Ardelean-Calin/plantbuddy-hw/3dcase/case.FCStd

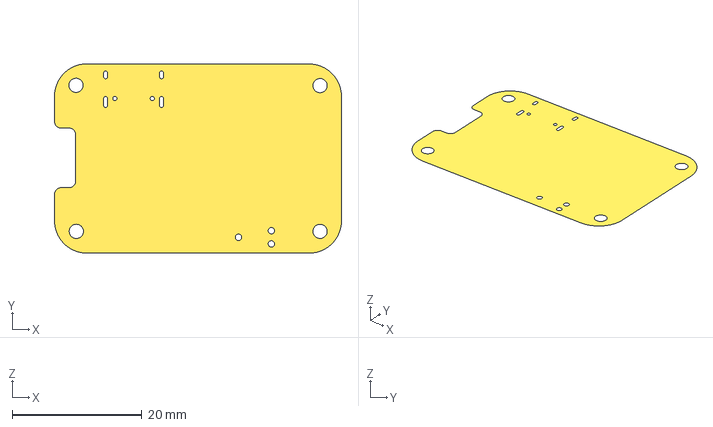
[picture p1: CAD file, 2022-11-03]
3dcase/case.FCStd
44.3 x 29.3 x 0 mm
