Ardelean-Calin/plantbuddy-hw/PlantBuddy.step

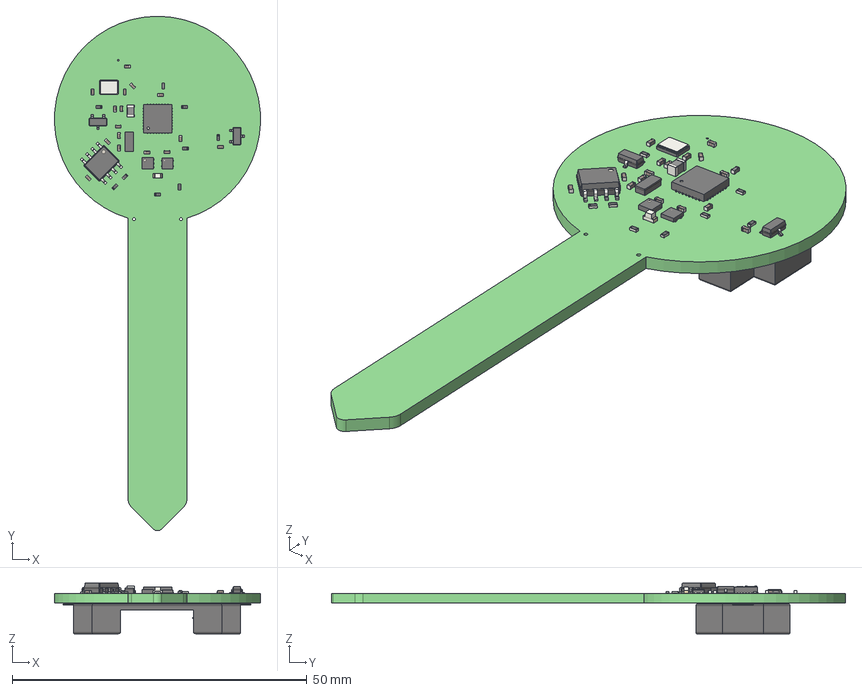
[picture p2: CAD file, 2021-03-22]
PlantBuddy.step
35.0 x 87.3 x 8.63 mm
