Ardelean-Calin/plantbuddy-hw/PlantBuddy.kicad_pcb

## KiCad design PlantBuddy.kicad_pcb (2023-06-27)

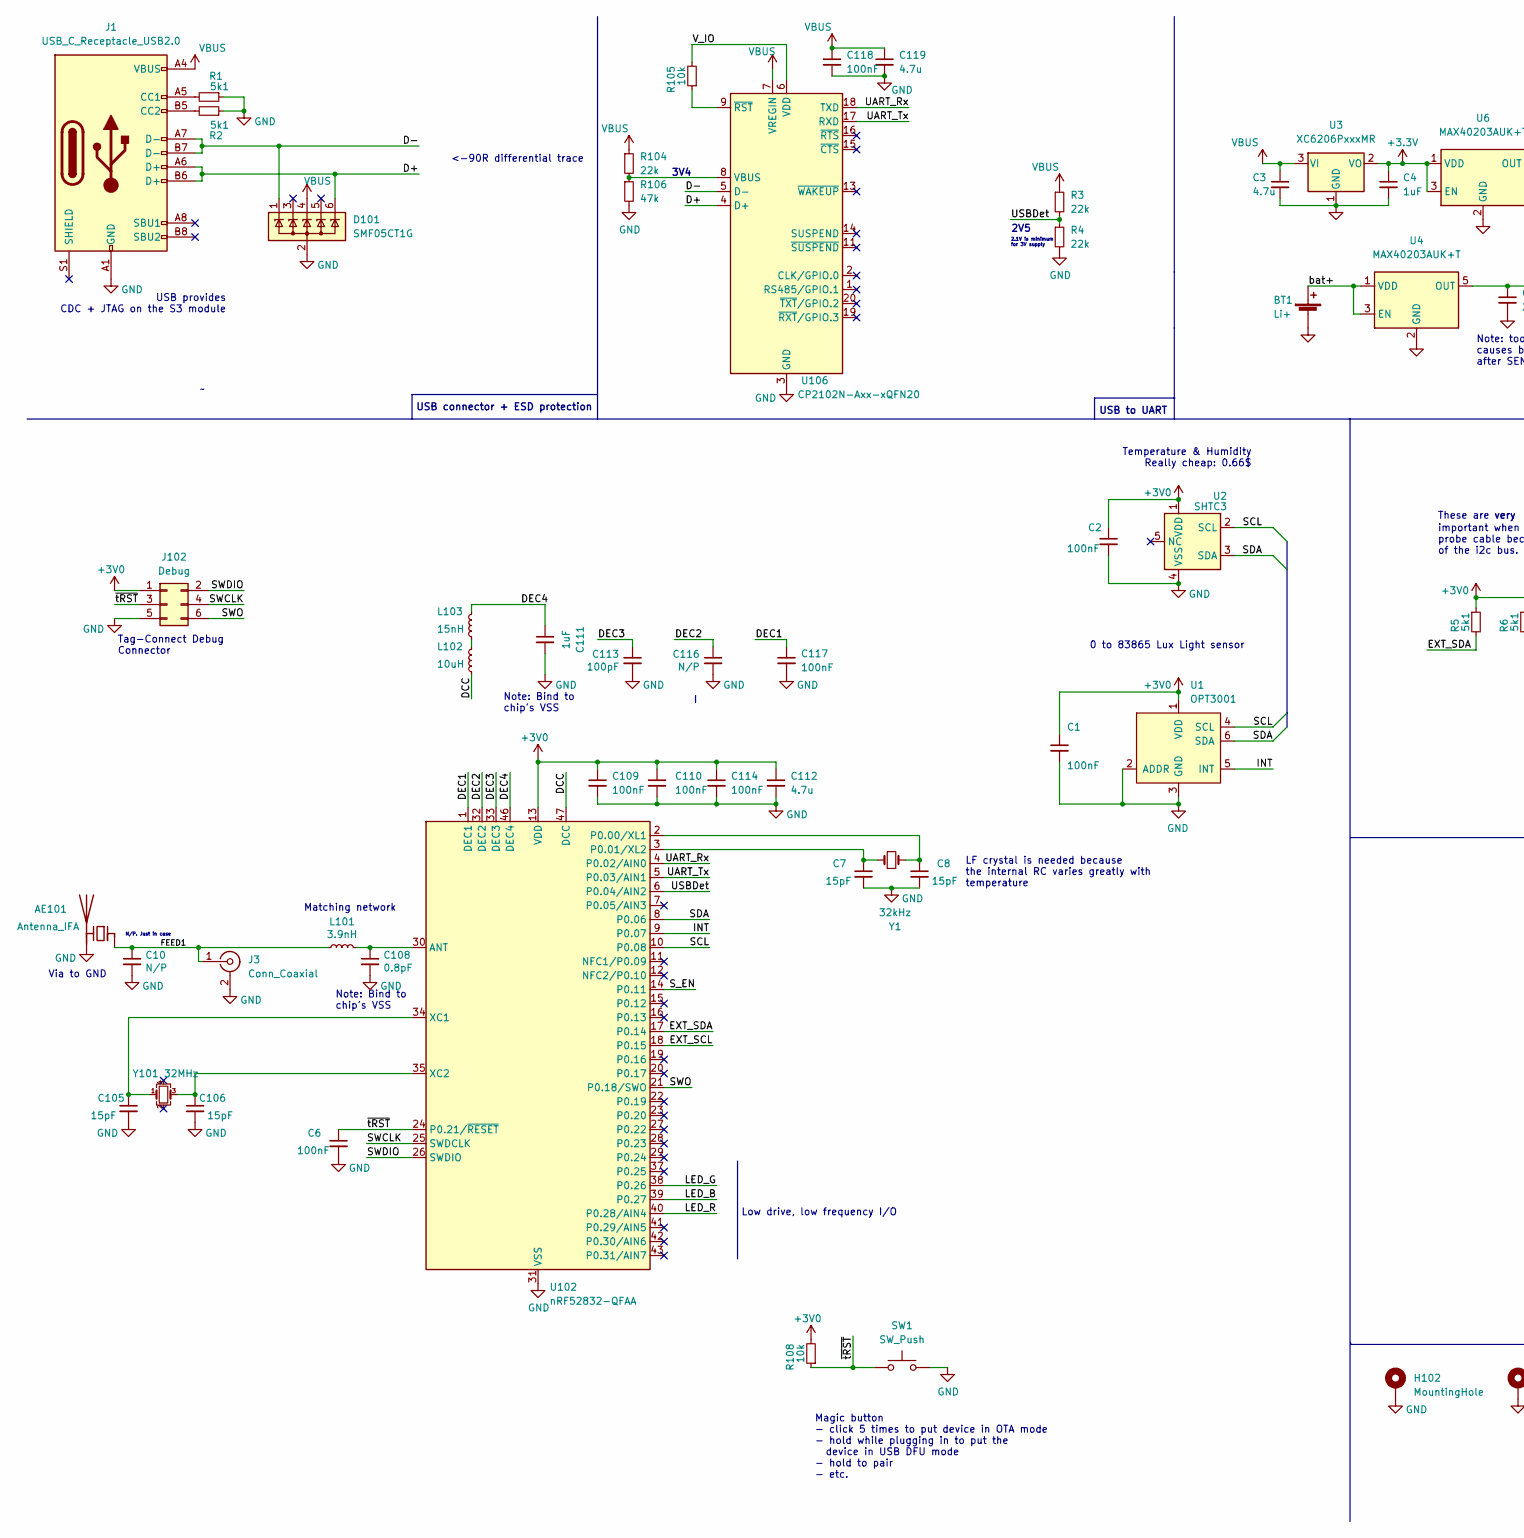
[picture p3: schematic PlantBuddy.kicad_sch, Plant Buddy, part in row 1, column 1]

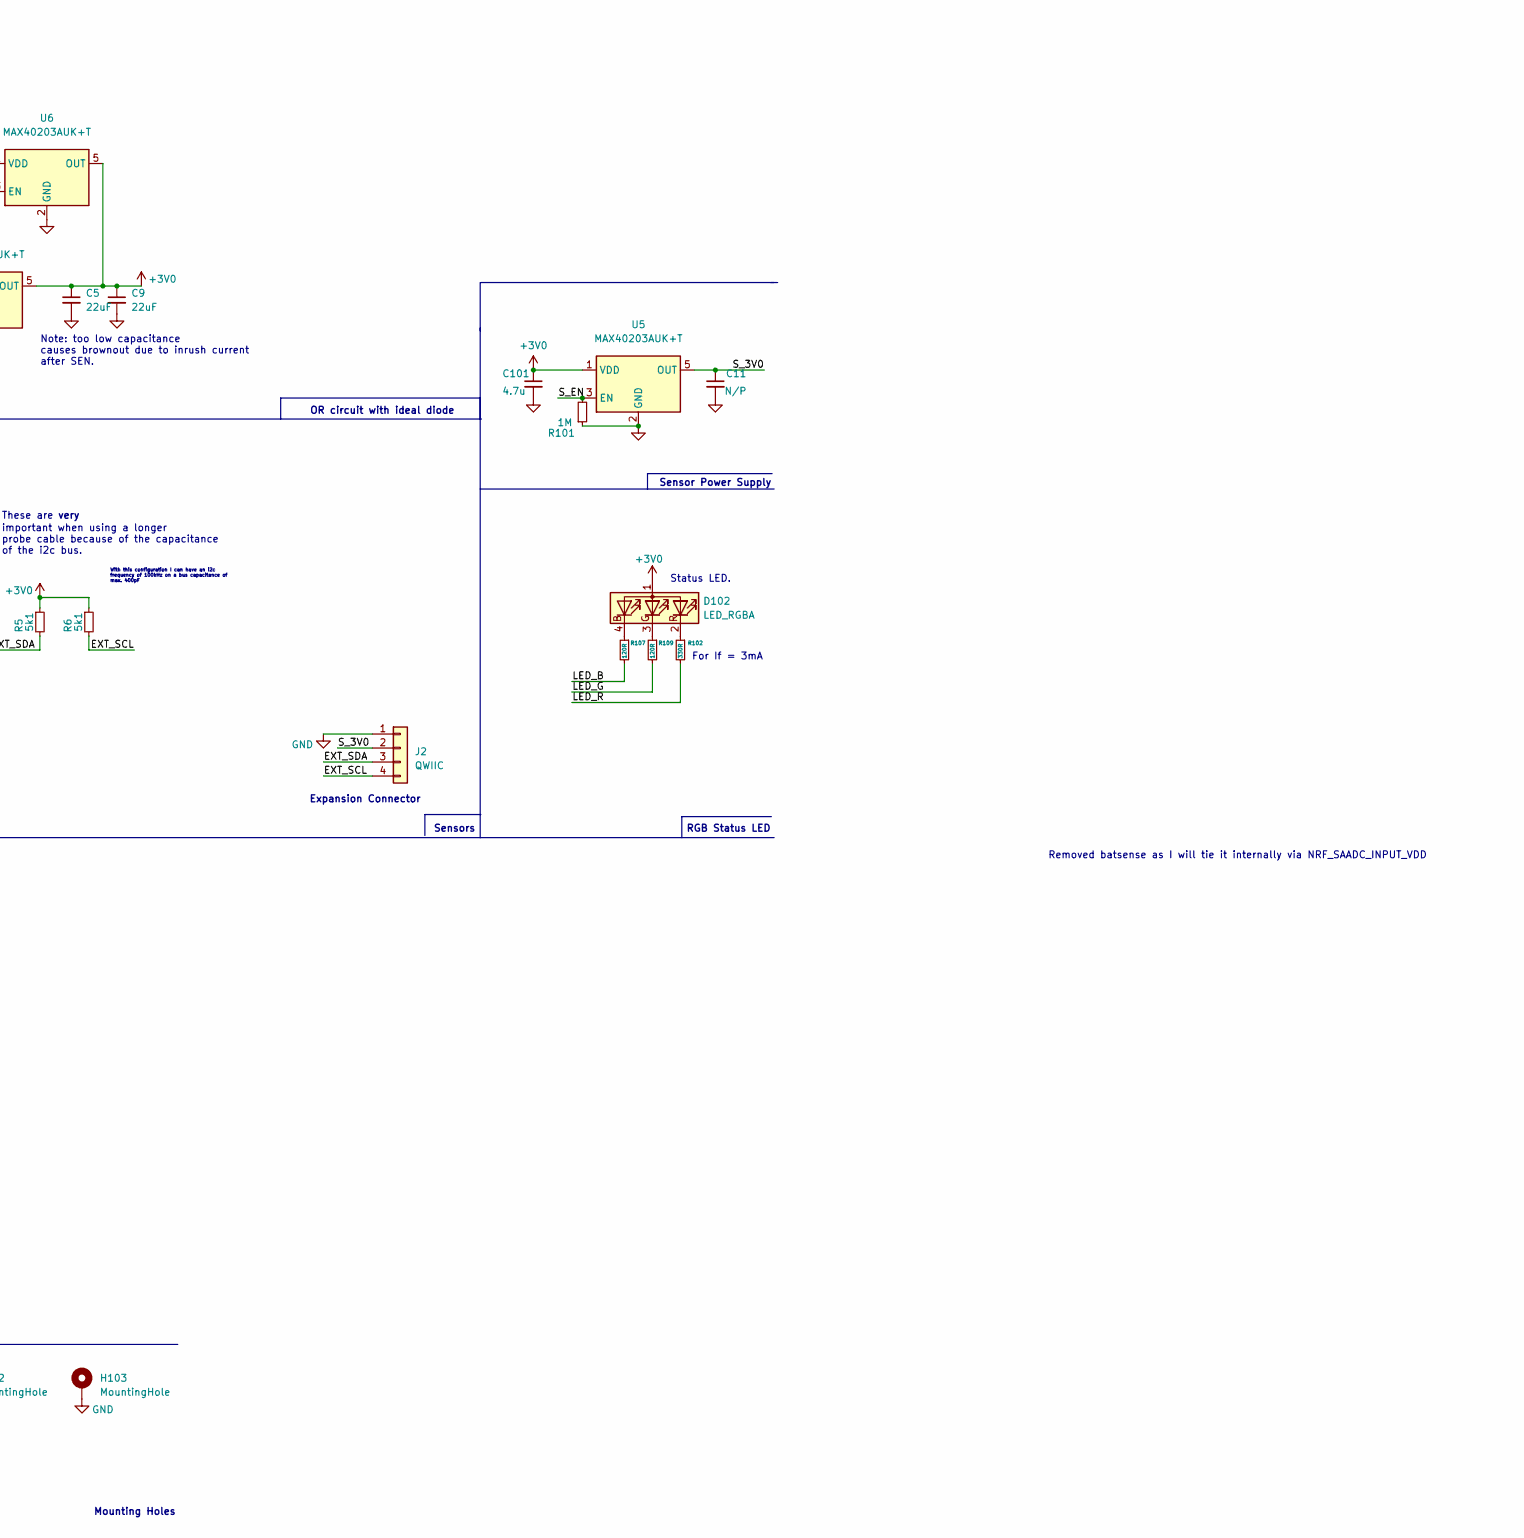
[picture p4: schematic PlantBuddy.kicad_sch, Plant Buddy, part in row 1, column 2]

Parts:
AE101: Antenna_IFA; ANT-F-1-2.4G-1.6MM-FR4-WCH
BT1: Li+; BatteryHolder_LCSC_2032; LCSC C70377
C1, C2, C109, C110, C114, C117, C118: 100nF; C_0402_1005Metric; MPN CC0603KRX7R9BB104; LCSC C307331
C3, C101, C112, C119: 4.7u; C_0402_1005Metric; MPN CL10A475KO8NNNC; LCSC C23733
C4: 1uF; C_0402_1005Metric; MPN CL10A475KO8NNNC; LCSC C52923
C5, C9: 22uF; C_0603_1608Metric; MPN CL10A475KO8NNNC; LCSC C59461
C6: 100nF; C_0402_1005Metric; MPN CL10A475KO8NNNC; LCSC C307331
C7, C8, C105, C106: 15pF; C_0402_1005Metric; LCSC C1548
C10, C116: N/P; C_0402_1005Metric
C11: N/P; C_0402_1005Metric; MPN CL10A475KO8NNNC
C108: 0.8pF; C_0402_1005Metric; LCSC C172820
C111: 1uF; C_0402_1005Metric; MPN CC0603KRX7R9BB104; LCSC C52923
C113: 100pF; C_0402_1005Metric; LCSC C1546
D101: SMF05CT1G; SOT-363_SC-70-6; LCSC C15879
D102: LED_RGBA; LED_Lumex_SML-LX0404SIUPGUSB; LCSC C404280
H102, H103: MountingHole; MountingHole_3.2mm_M3_DIN965_Pad
J1: USB_C_Receptacle_USB2.0; USB_C_Receptacle_HRO_TYPE-C-31-M-12; MPN TYPE-C-31-M-12; LCSC C165948
J2: QWIIC; JST_SH_SM04B-SRSS-TB_1x04-1MP_P1.00mm_Horizontal; LCSC C160404
J3: Conn_Coaxial; U.FL_Hirose_U.FL-R-SMT-1_Vertical; LCSC C88374
J102: Debug; Tag-Connect_TC2030-IDC-NL_2x03_P1.27mm_Vertical
L101: 3.9nH; L_0402_1005Metric; LCSC C76775
L102: 10uH; L_0603_1608Metric; LCSC C223240
L103: 15nH; L_0402_1005Metric; LCSC C27143
R1, R2, R5, R6: 5k1; R_0402_1005Metric; MPN 0603WAF5101T5E; LCSC C25905
R3, R4, R104: 22k; R_0402_1005Metric; LCSC C25768
R101: 1M; R_0402_1005Metric; MPN 0603WAF2004T5E; LCSC C26083
R102: 330R; R_0402_1005Metric; LCSC C25104
R105, R108: 10k; R_0402_1005Metric; MPN 0603WAF5101T5E; LCSC C25744
R106: 47k; R_0402_1005Metric; LCSC C25792
R107, R109: 120R; R_0402_1005Metric; LCSC C25079
SW1: SW_Push; SW_Push_SPST_NO_Alps_SKRK; MPN SKRKAEE020; LCSC C115357
U1: OPT3001; SON65P200X200X65-7N; LCSC C90462
U2: SHTC3; SON100P200X200X80-5N; MPN SHTC3; LCSC C194656
U3: XC6206PxxxMR; SOT-23; LCSC C5446
U4, U5, U6: MAX40203AUK+T; SOT-23-5; LCSC C2653639
U102: nRF52832-QFAA; QFN-48-1EP_6x6mm_P0.4mm_EP4.6x4.6mm; LCSC C77540
U106: CP2102N-Axx-xQFN20; SiliconLabs_QFN-20-1EP_3x3mm_P0.5mm_EP1.8x1.8mm; LCSC C969913
Y1: 32kHz; Crystal_SMD_3215-2Pin_3.2x1.5mm; LCSC C32346
Y101: 32MHz; Crystal_SMD_3225-4Pin_3.2x2.5mm; LCSC C90934

Connections:
+3.3V: C4.1, U3.2 (VO), U6.1 (VDD), U6.3 (EN)
+3V0: C1.1, C2.1, C5.1, C9.1, C101.1, C109.1, C110.1, C112.1, C114.1, D102.1 (A), J102.1, R5.1, R6.1, R108.2, U1.1 (VDD), U2.1 (VDD), U4.5 (OUT), U5.1 (VDD), U6.5 (OUT), U102.13 (VDD), U102.36 (VDD), U102.48 (VDD)
/D+: D101.6 (K), J1.A6 (D+), J1.B6 (D+), U106.4 (D+)
/D-: D101.1 (K), J1.A7 (D-), J1.B7 (D-), U106.5 (D-)
/DCC: L102.2, U102.47 (DCC)
/DEC1: C117.1, U102.1 (DEC1)
/DEC2: C116.1, U102.32 (DEC2)
/DEC3: C113.1, U102.33 (DEC3)
/DEC4: C111.1, L103.1, U102.46 (DEC4)
/EXT_SCL: J2.4, R6.2, U102.18 (P0.15)
/EXT_SDA: J2.3, R5.2, U102.17 (P0.14)
/FEED1: AE101.1 (FEED), C10.1, J3.1 (In), L101.1
/INT: U1.5 (INT), U102.9 (P0.07)
/LED_B: R107.2, U102.39 (P0.27)
/LED_G: R109.2, U102.38 (P0.26)
/LED_R: R102.2, U102.40 (P0.28/AIN4)
/SCL: U1.4 (SCL), U2.2 (SCL), U102.10 (P0.08)
/SDA: U1.6 (SDA), U2.3 (SDA), U102.8 (P0.06)
/SWCLK: J102.4, U102.25 (SWDCLK)
/SWDIO: J102.2, U102.26 (SWDIO)
/SWO: J102.6, U102.21 (P0.18/SWO)
/S_3V0: C11.1, J2.2, U5.5 (OUT)
/S_EN: R101.2, U5.3 (EN), U102.14 (P0.11)
/UART_Rx: U102.4 (P0.02/AIN0), U106.18 (TXD)
/UART_Tx: U102.5 (P0.03/AIN1), U106.17 (RXD)
/USBDet: R3.2, R4.1, U102.6 (P0.04/AIN2)
/V_IO: R105.2, U106.6 (VDD)
/bat+: BT1.1 (+), U4.1 (VDD), U4.3 (EN)
/~tRST: C6.1, J102.3, R108.1, SW1.1, U102.24 (P0.21/~RESET)
GND: AE101.2 (PCB_Trace), BT1.2 (-), C1.2, C2.2, C3.2, C4.2, C5.2, C6.2, C7.2, C8.2, C9.2, C10.2, C11.2, C101.2, C105.2, C106.2, C108.2, C109.2, C110.2, C111.2, C112.2, C113.2, C114.2, C116.2, C117.2, C118.2, C119.2, D101.2 (A), H102.1, H103.1, J1.A1 (GND), J1.A12 (GND), J1.B1 (GND), J1.B12 (GND), J2.1, J3.2 (Ext), J102.5, R1.1, R2.1, R4.2, R101.1, R106.2, SW1.2, U1.2 (ADDR), U1.3 (GND), U1.7 (PAD), U2.4 (VSS), U3.1 (GND), U4.2 (GND), U5.2 (GND), U6.2 (GND), U102.31 (VSS), U102.45 (VSS), U102.49 (VSS), U106.3 (GND), U106.12 (GND), U106.21 (GND)
unnamed: D102.4 (BK), R107.1
unnamed: D102.3 (GK), R109.1
unnamed: D102.2 (RK), R102.1
unnamed: J1.A5 (CC1), R1.2
unnamed: J1.B5 (CC2), R2.2
unnamed: L102.1, L103.2
unnamed: C108.1, L101.2, U102.30 (ANT)
unnamed: C8.1, U102.2 (P0.00/XL1), Y1.2
unnamed: C7.1, U102.3 (P0.01/XL2), Y1.1
unnamed: C105.1, U102.34 (XC1), Y101.1
unnamed: C106.1, U102.35 (XC2), Y101.3
unnamed: R104.2, R106.1, U106.8 (VBUS)
unnamed: R105.1, U106.9 (~RST)
VBUS: C3.1, C118.1, C119.1, D101.4 (K), J1.A4 (VBUS), J1.A9 (VBUS), J1.B4 (VBUS), J1.B9 (VBUS), R3.1, R104.1, U3.3 (VI), U106.7 (VREGIN)

Notes on the sheet:
very
Sensors
Note: too low capacitance causes brownout due to inrush current after SEN.
These are
USB provides CDC + JTAG on the S3 module
Magic button - click 5 times to put device in OTA mode - hold while plugging in to put the device in USB DFU mode - hold to pair - etc.
Via to GND
RGB Status LED
Tag-Connect Debug Connector
Expansion Connector
Removed batsense as I will tie it internally via NRF_SAADC_INPUT_VDD
Sensor Power Supply
2.1V is minimum for 3V supply
important when using a longer probe cable because of the capacitance of the i2c bus.
Low drive, low frequency I/O
Note: Bind to chip's VSS
3V4
<-90R differential trace
0 to 83865 Lux Light sensor
Temperature & Humidity Really cheap: 0.66$
With this configuration I can have an i2c frequency of 100kHz on a bus capacitance of max. 400pF
Matching network
Mounting Holes
For If = 3mA
LF crystal is needed because the internal RC varies greatly with temperature
2V5
OR circuit with ideal diode
Status LED.
N/P. Just in case
USB connector + ESD protection
USB to UART

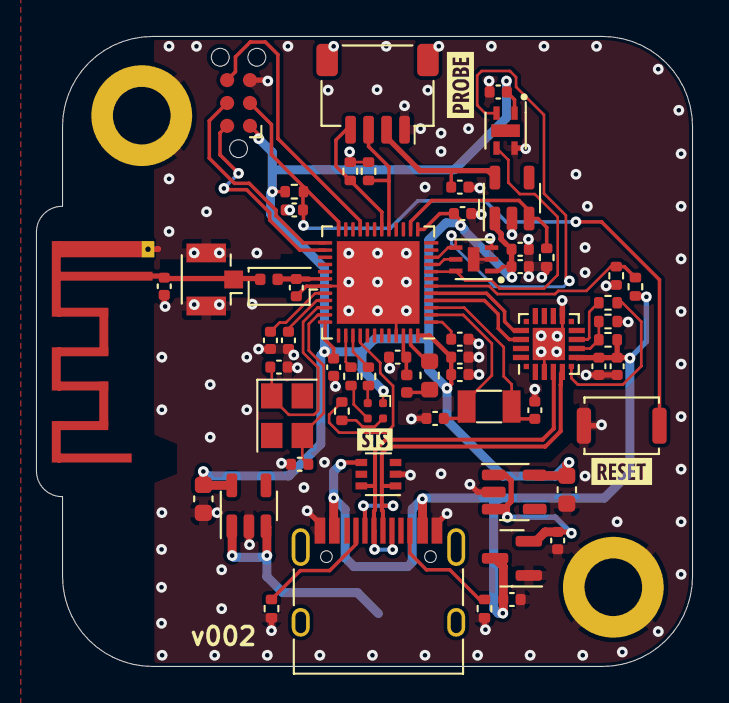
[picture p5: board PlantBuddy.kicad_pcb from above]

Board: 4 copper layers, 36.4 x 35.0 mm, 63 parts (1 on the bottom side), 44 nets.
