Ardelean-Calin/plantbuddy-hw/(commit log)

2020-10-13 Backup. Schematic done, I think
    [BoardOutline.dxf, PlantBuddy.kicad_pcb, PlantBuddy.sch]
2020-10-13 PCB almost done
    [PlantBuddy.kicad_pcb, PlantBuddy.sch]
2020-10-14 Initial Layout done
    [BoardOutline.dxf, PlantBuddy.kicad_pcb, PlantBuddy.sch]
2020-10-15 Ordered PCB
    [PlantBuddy-B_Cu.gbr, PlantBuddy-B_Mask.gbr, PlantBuddy-B_SilkS.gbr, PlantBuddy-Edge_Cuts.gbr, PlantBuddy-F_Cu.gbr, PlantBuddy-F_Mask.gbr, PlantBuddy-F_SilkS.gbr, PlantBuddy-In1_Cu.gbr]
2020-11-04 Evrika! We have an LED blinking! 🔥🎉💯
    [PlantBuddy.kicad_pcb, PlantBuddy.sch]
2020-11-05 Changed LED frequenct
2020-11-10 Removed STM32CubeMx file
2020-11-11 Basic SHT2X temperature logging
2020-11-12 Air Temperature and Humidity now working! 🌡🌧
2020-11-17 Configured timer for soil humidity measurement.
2020-11-17 Just some small typo fix.
    [PlantBuddy.sch]
2020-11-22 Modified I2C read/write operations to be more readable
2020-11-23 Slight refactoring of SHT2X module. Still can't go low-power
2020-11-23 Reduced tick frequency in preparation for low-power
2020-11-26 Added low-power configuration for SHT2X
2020-11-26 Started schematic revision
    [PlantBuddy.sch]
2020-11-28 Revised schematic
    [PlantBuddy.sch]
2020-11-28 Revised PCB
    [PlantBuddy.kicad_pcb]
2020-11-28 Ordered PCB version 2
    [PlantBuddy-B_Cu.gbr, PlantBuddy-B_Mask.gbr, PlantBuddy-B_SilkS.gbr, PlantBuddy-Edge_Cuts.gbr, PlantBuddy-F_Cu.gbr, PlantBuddy-F_Mask.gbr, PlantBuddy-F_SilkS.gbr, PlantBuddy-In1_Cu.gbr]
2020-12-05 Added documentation for the last humidity sensor
2020-12-05 Changed tick frequency to 100Hz
2020-12-24 Added datasheet for lux sensor
2020-12-24 Now reading RH and T with new sensor
2020-12-31 Refactored i2c module & SHT2C driver
2021-01-01 Started communicating with lux sensor
2021-01-02 Lux sensor implementation ready.
2021-01-06 Switched to CMAKE
2021-01-15 Moved to Linux
    [BoardOutline.dxf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]
2021-01-29 Switched to nRF52810.
    [PlantBuddy-B_Cu.gbr, PlantBuddy-B_Mask.gbr, PlantBuddy-B_SilkS.gbr, PlantBuddy-Edge_Cuts.gbr, PlantBuddy-F_Cu.gbr, PlantBuddy-F_Mask.gbr, PlantBuddy-F_SilkS.gbr, PlantBuddy-In1_Cu.gbr]
2021-02-05 Switched to nRF52810
2021-02-05 Disabled LED Button service!
2021-02-15 SHTC3 temperature and humidity now working!
2021-02-15 Added documentation to SHTC3 driver.
2021-02-16 OPT3001 driver done.
2021-02-16 Added battery sensor module.
2021-02-18 LEDs now not blinkin!
2021-02-18 Added buttonless DFU functionality!
2021-02-18 Changed frequency of status LED blinking
2021-02-25 Slight hardware changes.
    [PlantBuddy.sch]
2021-02-25 Added air temperature and humidity characteristics
2021-03-05 Revised 3d models a bit
    [PlantBuddy.kicad_pcb, PlantBuddy.sch, PlantBuddy.step]
2021-03-05 Added 3d model for the case
    [Prototype v29.f3z]
2021-03-09 Slight PCB modifications
    [FlivzNexxy-B_Cu.gbr, FlivzNexxy-B_Mask.gbr, FlivzNexxy-B_SilkS.gbr, FlivzNexxy-Edge_Cuts.gbr, FlivzNexxy-F_Cu.gbr, FlivzNexxy-F_Mask.gbr, FlivzNexxy-F_SilkS.gbr, FlivzNexxy-In1_Cu.gbr]
2021-03-10 Changed to two-layer PCB
    [FlivzNexxy-B_Cu.gbr, FlivzNexxy-B_Mask.gbr, FlivzNexxy-B_SilkS.gbr, FlivzNexxy-Edge_Cuts.gbr, FlivzNexxy-F_Cu.gbr, FlivzNexxy-F_Mask.gbr, FlivzNexxy-F_SilkS.gbr, FlivzNexxy-In1_Cu.gbr]
2021-03-10 Slight modifications to two-layer version
    [FlivzNexxy_BOM.xlsx, PlantBuddy.sch]
2021-03-11 Ordered 2-layer PCB from PCBway
    [FlivzNexxy_BOM.xlsx, PlantBuddy.kicad_pcb]
2021-03-22 Lowered sensor data aquisition time to reduce power.
2021-03-22 Updated 3D model
    [PlantBuddy.step]
2021-04-09 Switched to nRF52811.
2021-04-13 Enabled PIN-based pairing.
2021-04-26 Added timestamp to BLE characteristic. Switched to human-readable representation of humidity and temperature in data packet. Added jupyter notebook that extracts all sensor data.
2021-04-27 Added battery voltage to sensor package (temporary)
2021-04-28 Removed static PIN and made slight adaptations to RELEASE
2021-04-28 Switched to pipenv for python code.
2021-05-09 Switched to Linux... again.
2021-08-06 Just some small UPPER-CASE correction
2021-08-06 Added logging via UART.
2021-08-11 Added devcontainer using docker! 🎉🐋
2021-08-11 Re-added phone app now with docker! 🐋
2021-08-14 PlantBuddy Revision 3. Switched to nRF52832
    [FlivzNexxy-B_Cu.gbr, FlivzNexxy-B_Mask.gbr, FlivzNexxy-B_SilkS.gbr, FlivzNexxy-Edge_Cuts.gbr, FlivzNexxy-F_Cu.gbr, FlivzNexxy-F_Mask.gbr, FlivzNexxy-F_SilkS.gbr, FlivzNexxy-NPTH.drl]
2021-08-15 Fixed revision number.
    [PlantBuddy.sch]
2021-08-16 HW: Rev 4.1 => Changed ALS from OPT3001 to LTR-303
    [PlantBuddy.kicad_pcb, PlantBuddy.sch]
2021-09-04 Started PCB improvements & added SVGs and interactive BOM.
    [PlantBuddy.kicad_pcb, PlantBuddy.sch, PlantBuddy_bom.csv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]
2021-09-05 Added new debug connector for J-Link.
    [PlantBuddy.kicad_pcb, PlantBuddy.sch]
2021-09-06 Embedded: Updated capacitive sensing mechanism.
2021-09-06 PCB: Changed name of net.
    [PlantBuddy.sch]
2021-09-07 Removed unneeded high-level CSENSE driver.
2021-09-09 Corrected device identifier.
2021-09-09 Disabled soilhumidity driver because it didn't work.
2021-09-10 Changed antenna design to monopole
    [PlantBuddy.kicad_pcb, PlantBuddy.sch]
2021-09-10 Switched to 0603 and re-did layout.
    [PlantBuddy.kicad_pcb, PlantBuddy.sch]
2021-09-10 Done with latest HW revision. To be ordered with Aisler.
    [PlantBuddy.kicad_pcb, PlantBuddy.sch]
2021-09-10 Slight adjustments to Antenna ground plane & length.
    [PlantBuddy.kicad_pcb]
2021-09-10 Slight changes to RF trace width.
    [PlantBuddy.kicad_pcb]
2021-09-28 Updated interactive BOM
2021-09-28 Adapted firmware to run on latest development board from AISLER.
2021-09-28 Incipient LTR303 driver.
2021-09-29 SHTC3 driver now works!
2021-10-01 All sensors now working!
2021-10-15 Slight schematic TODO added
    [PlantBuddy.sch]
2021-10-19 Switched to podman.
2021-11-09 Added current sense resistor & COMP resistor.
    [FlivzNexxy-B_Cu.gbl, FlivzNexxy-B_Cu.gbr, FlivzNexxy-B_Mask.gbr, FlivzNexxy-B_Mask.gbs, FlivzNexxy-B_Paste.gbp, FlivzNexxy-B_SilkS.gbo, FlivzNexxy-B_SilkS.gbr, FlivzNexxy-Edge_Cuts.gm1]
2021-11-10 Corrected PCB BOM.
    [BOM_manual_edit.csv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]
2022-04-21 Switched to ESP32
    [PlantBuddy.kicad_pcb, PlantBuddy.kicad_sch]
2022-04-29 Had to change the way we do capacitive soil humidity.
    [FlivzNexxy-B_Cu.gbl, FlivzNexxy-B_Mask.gbs, FlivzNexxy-B_Paste.gbp, FlivzNexxy-B_SilkS.gbo, FlivzNexxy-Edge_Cuts.gm1, FlivzNexxy-F_Cu.gtl, FlivzNexxy-F_Mask.gts, FlivzNexxy-F_Paste.gtp]
2022-05-05 Added tooling holes.
    [PlantBuddy.kicad_pcb, PlantBuddy.kicad_sch]
2022-05-06 Added reverse voltage protection; status LED; changed resistance of green LED; changed piezo footprint
    [PlantBuddy-CmtUser.gbr, PlantBuddy-CuBottom.gbl, PlantBuddy-CuTop.gtl, PlantBuddy-EdgeCuts.gm1, PlantBuddy-MaskBottom.gbs, PlantBuddy-MaskTop.gts, PlantBuddy-PasteBottom.gbp, PlantBuddy-PasteTop.gtp]
2022-05-24 Moved temperature sensor to the edge of the board.
    [PlantBuddy.kicad_pcb, PlantBuddy.kicad_sch]
2022-05-27 Simplified capacitance measurement
    [PlantBuddy.kicad_pcb, PlantBuddy.kicad_sch]
2022-06-15 Temperature calibrated capacitive sensing & ordered from JLCPCB
    [PlantBuddy-CmtUser.gbr, PlantBuddy-CuBottom.gbl, PlantBuddy-CuTop.gtl, PlantBuddy-EdgeCuts.gm1, PlantBuddy-MaskBottom.gbs, PlantBuddy-MaskTop.gts, PlantBuddy-PasteBottom.gbp, PlantBuddy-PasteTop.gtp]
2022-06-19 Removed previous CPL file
    [FlivzNexxy_cpl_top.csv]
2022-06-27 New board based on ESP32-S3 mostly done. Waiting for part availability...
    [PlantBuddy.kicad_pcb, PlantBuddy.kicad_sch]
2022-06-28 Removed reverse protection circuit as it did nothing to protect the battery charger from reverse voltage.
    [PlantBuddy.kicad_pcb, PlantBuddy.kicad_sch]
2022-06-28 Silkscreen & testpoints
    [PlantBuddy-CmtUser.gbr, PlantBuddy-CuBottom.gbl, PlantBuddy-CuTop.gtl, PlantBuddy-EdgeCuts.gm1, PlantBuddy-MaskBottom.gbs, PlantBuddy-MaskTop.gts, PlantBuddy-PasteBottom.gbp, PlantBuddy-PasteTop.gtp]
2022-06-28 Changed pin layout to have more EXT pins
    [PlantBuddy.kicad_pcb, PlantBuddy.kicad_sch]
2022-06-30 Added different mezzannine connector
    [PlantBuddy.kicad_pcb, PlantBuddy.kicad_sch]
2022-07-01 Changed connector to a more solid one.
    [PlantBuddy-CmtUser.gbr, PlantBuddy-CuBottom.gbl, PlantBuddy-CuTop.gtl, PlantBuddy-EdgeCuts.gm1, PlantBuddy-MaskBottom.gbs, PlantBuddy-MaskTop.gts, PlantBuddy-PasteBottom.gbp, PlantBuddy-PasteTop.gtp]
2022-07-02 Added 3D models for everything
    [PlantBuddy-CmtUser.gbr, PlantBuddy-CuBottom.gbl, PlantBuddy-CuTop.gtl, PlantBuddy-EdgeCuts.gm1, PlantBuddy-MaskBottom.gbs, PlantBuddy-MaskTop.gts, PlantBuddy-PasteBottom.gbp, PlantBuddy-PasteTop.gtp]
2022-07-03 Created a 2-layer board variant.
    [PlantBuddy.kicad_pcb]
2022-07-03 Small cleanup & impedance matching
    [PlantBuddy.kicad_pcb]
2022-07-03 Rounded slot of sensor area
    [PlantBuddy.kicad_pcb]
2022-07-03 Expanded antenna keep-out zone a bit
    [PlantBuddy-CmtUser.gbr, PlantBuddy-CuBottom.gbl, PlantBuddy-CuTop.gtl, PlantBuddy-EdgeCuts.gm1, PlantBuddy-MaskBottom.gbs, PlantBuddy-MaskTop.gts, PlantBuddy-PasteBottom.gbp, PlantBuddy-PasteTop.gtp]
2022-07-03 Removed gerbers from source control
    [PlantBuddy-CmtUser.gbr, PlantBuddy-CuBottom.gbl, PlantBuddy-CuTop.gtl, PlantBuddy-EdgeCuts.gm1, PlantBuddy-MaskBottom.gbs, PlantBuddy-MaskTop.gts, PlantBuddy-PasteBottom.gbp, PlantBuddy-PasteTop.gtp]
2022-07-04 Separated temperature sensor ground plane
    [PlantBuddy.kicad_pcb]
2022-07-13 Fixed PCB & ordered from JLCPCB
    [PlantBuddy.kicad_pcb]
2022-07-19 Fixed 3D model of USB-C connector
    [PlantBuddy.kicad_pcb]
2022-07-22 Converted to proper 4-layer and ordered PCB
    [BOM_manual_edit.csv, PlantBuddy.kicad_pcb, PlantBuddy.kicad_sch, bom.csv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]
2022-07-22 Removed ground plane under antenna
    [PlantBuddy.kicad_pcb]
2022-07-25 Adapted differential pair impedance
    [PlantBuddy.kicad_pcb]
2022-07-26 Fixed board after first batch arrived. Changed connector to FFC.
    [PlantBuddy.kicad_pcb, PlantBuddy.kicad_sch, bom.csv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]
2022-07-26 Fixed hole sizes
    [PlantBuddy.kicad_pcb]
2022-07-28 Made copper fill under temperature sensor bigger.
    [PlantBuddy.kicad_pcb]
2022-07-30 Moved temp mid to ADC1_CH8 & batsense to ADC1_CH7. To note: only ADC1 can be used if WiFi is enabled!
    [PlantBuddy.kicad_pcb, PlantBuddy.kicad_sch]
2022-08-14 Added power distribution switch for external connector
    [PlantBuddy.kicad_pcb, PlantBuddy.kicad_sch]
2022-08-14 Changed 100nF capacitors to 0402
    [PlantBuddy.kicad_pcb, PlantBuddy.kicad_sch]
2022-08-14 Removed current shunt & generated build files.
    [PlantBuddy.kicad_pcb, PlantBuddy.kicad_sch, bom.csv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]
2022-08-18 Switched to ESP32-S3-Mini and changed PCB shape
    [PlantBuddy.kicad_pcb, PlantBuddy.kicad_sch, bom.csv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]
2022-08-19 Added copper heatsink to temperature sensor.
    [PlantBuddy.kicad_pcb, PlantBuddy.kicad_sch]
2022-08-20 Multitude of changes. Hopefully design freeze.
    - Switched JST connector to a bigger 2mm pitch one.
    - Added battery protection circuit for coin cell.
    - Created cutout in PCB for battery cable.
    - Added heatsink for SHTC3.
    - Added plated mounting holes for looks and power dissipation.
    - Changed pin layout to facilitate wake-up via USB-C plug-in detection.
    - Added ARTech logo.
    [PlantBuddy.kicad_pcb, PlantBuddy.kicad_sch, bom.csv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]
2022-08-22 Added Voltage Supervisor circuit.
    LMS33460 is used as a voltage supervisor circuit meant to protect the
    ESP32, as well as the battery, if a low-voltage condition is detected.
    [PlantBuddy.kicad_pcb, PlantBuddy.kicad_sch, bom.csv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]
2022-08-22 Generated latest STL model.
2022-08-22 Changed CR2450 holder to cheaper, non-plated one.
    [PlantBuddy.kicad_sch]
2022-08-31 Went back to nRF52832 for 1-year battery life.
    [PlantBuddy.kicad_pcb, PlantBuddy.kicad_sch]
2022-08-31 Fixes & ordered.
    [PlantBuddy.kicad_pcb, PlantBuddy.kicad_sch, bom.csv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]
2022-08-31 Slight BOM consolidation.
    - Changed 9.1k resistor to a 10k one.
    - Changed 470k resistor to a 1Meg one.
    [PlantBuddy.kicad_pcb, PlantBuddy.kicad_sch]
2022-09-04 Major PCB changes.
    - Added inductor for nRF52 DCDC converter.
    - Moved USB-C connector to bottom left.
    - Moved USB charger and battery protection IC.
    - Moved USB-to-serial converter.
    - Changed pinout to simplify routing.
    [PlantBuddy.kicad_pcb, PlantBuddy.kicad_sch, bom.csv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]
2022-09-17 Optimised PCB layout.
    -
    [PlantBuddy.kicad_pcb]
2022-09-21 Added proper MPN for Nordic chip
    [PlantBuddy.kicad_pcb, PlantBuddy.kicad_sch]
2022-09-22 Moved antenna
    [PlantBuddy.kicad_pcb, PlantBuddy.kicad_sch]
2022-09-23 Last order before main order. NO MORE ORDERS ALLOWED
    [PlantBuddy.kicad_pcb, PlantBuddy.kicad_sch, bom.csv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]
2022-09-25 Added voltage monitoring IC. Shuts everything down if Vbat < 3V
    [PlantBuddy.kicad_pcb, PlantBuddy.kicad_sch]
2022-09-26 Fixed high power consumption when Vsupply < 3V3
    - Added 3V LDO instead of 3.3V LDO.
    - Changed RGB LED from Neopixel to simple PWM-based.
    [PlantBuddy.kicad_pcb, PlantBuddy.kicad_sch]
2022-09-26 Exchanged debug connector for Tag-Connect TC2030-CTX-NL
    [PlantBuddy.kicad_pcb, PlantBuddy.kicad_sch]
2022-09-26 Added JLCPCB tooling holes & moved mounting holes.
    [PlantBuddy.kicad_pcb, PlantBuddy.kicad_sch]
2022-09-29 Switched LDO to a better, brand-name one.
    - Also am now powering the i2c sensors directly from the LDO because I
    noticed current spikes in the previous EN -> measure -> DIS
    implementation.
    [PlantBuddy.kicad_pcb, PlantBuddy.kicad_sch]
2022-10-05 Switched to single i2c bus.
    [PlantBuddy.kicad_pcb, PlantBuddy.kicad_sch]
2022-10-07 Changed antenna configuration back.
    After testing I found out that this antenna configuration works
    better.
    [PlantBuddy.kicad_pcb, PlantBuddy.kicad_sch]
2022-11-03 Changed to IFA antenna
    [PlantBuddy.kicad_pcb, PlantBuddy.kicad_sch, case.FCStd]
2022-11-08 Changed antenna to 1.6mm-compatible one
    [PlantBuddy.kicad_pcb, PlantBuddy.kicad_sch]
2022-11-09 Corrected LED pins
    [PlantBuddy.kicad_pcb, PlantBuddy.kicad_sch, bom.csv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]
2022-11-21 Added probe as submodule
2022-11-29 Added probe present detection via EXT8.
2022-12-08 Connected button to reset pin
    [PlantBuddy.kicad_pcb, PlantBuddy.kicad_sch]
2022-12-20 Created and ordered a non-rechargeable version.
    [PlantBuddy.kicad_pcb, PlantBuddy.kicad_sch, bom.csv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]
2022-12-20 Updated coax connector placement
    [PlantBuddy.kicad_pcb]
2023-01-04 Enhanced silkscreen layer.
    [PlantBuddy.kicad_pcb]
2023-01-07 Fixed probe not working due to brownout
    [PlantBuddy.kicad_pcb, PlantBuddy.kicad_sch]
2023-01-08 PCB changes after testing.
    - separated i2c buses
    - changed layer stackup to sig-gnd-gnd-sig
    - added top & bottom ground layers
    - routed power on bottom layer
    - added LF crystal
    [PlantBuddy.kicad_pcb, PlantBuddy.kicad_sch]
2023-01-08 Improved power consumption.
    - Added i2c pull up resistors, as they are needed for external probe
    with long cable.
    - Wanted to add a coax TP, but that's actually not needed.
    [PlantBuddy.kicad_pcb, PlantBuddy.kicad_sch]
2023-01-08 Tuned USB differential pair
    [PlantBuddy.kicad_pcb, PlantBuddy.kicad_sch]
2023-01-09 Added solder-mask over antenna.
    [PlantBuddy.kicad_pcb, bom.csv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]
2023-01-09 Switched ALS to OPT3001
    [PlantBuddy.kicad_pcb, PlantBuddy.kicad_sch, bom.csv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]
2023-01-09 Added N/P capacitor at the output of SEN.
    [PlantBuddy.kicad_pcb, PlantBuddy.kicad_sch, bom.csv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]
2023-01-10 Simplified silkscreen text.
    [PlantBuddy.kicad_pcb]
2023-01-11 Made the first production order. 30pcs
    [PlantBuddy.kicad_pcb, PlantBuddy.kicad_sch]
2023-06-27 Changed connector to QWIIC & moved USB-C lower
    [PlantBuddy.kicad_pcb, PlantBuddy.kicad_sch]
2023-06-27 Added U.FL connector and moved antenna.
    [PlantBuddy.kicad_pcb, PlantBuddy.kicad_sch]
2023-07-20 Corrected build.sh and ordered 5ps
    [bom.csv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]
